bgould/kint/parts.txt

https://www.digikey.com/en/products/detail/jst-sales-america-inc/BM04B-SRSS-TB-LF-SN/926696
https://www.digikey.com/en/products/detail/jst-sales-america-inc/SM04B-SRSS-TB-LF-SN/926710
