bgould/kint/schematic-v2023-03-18.pdf

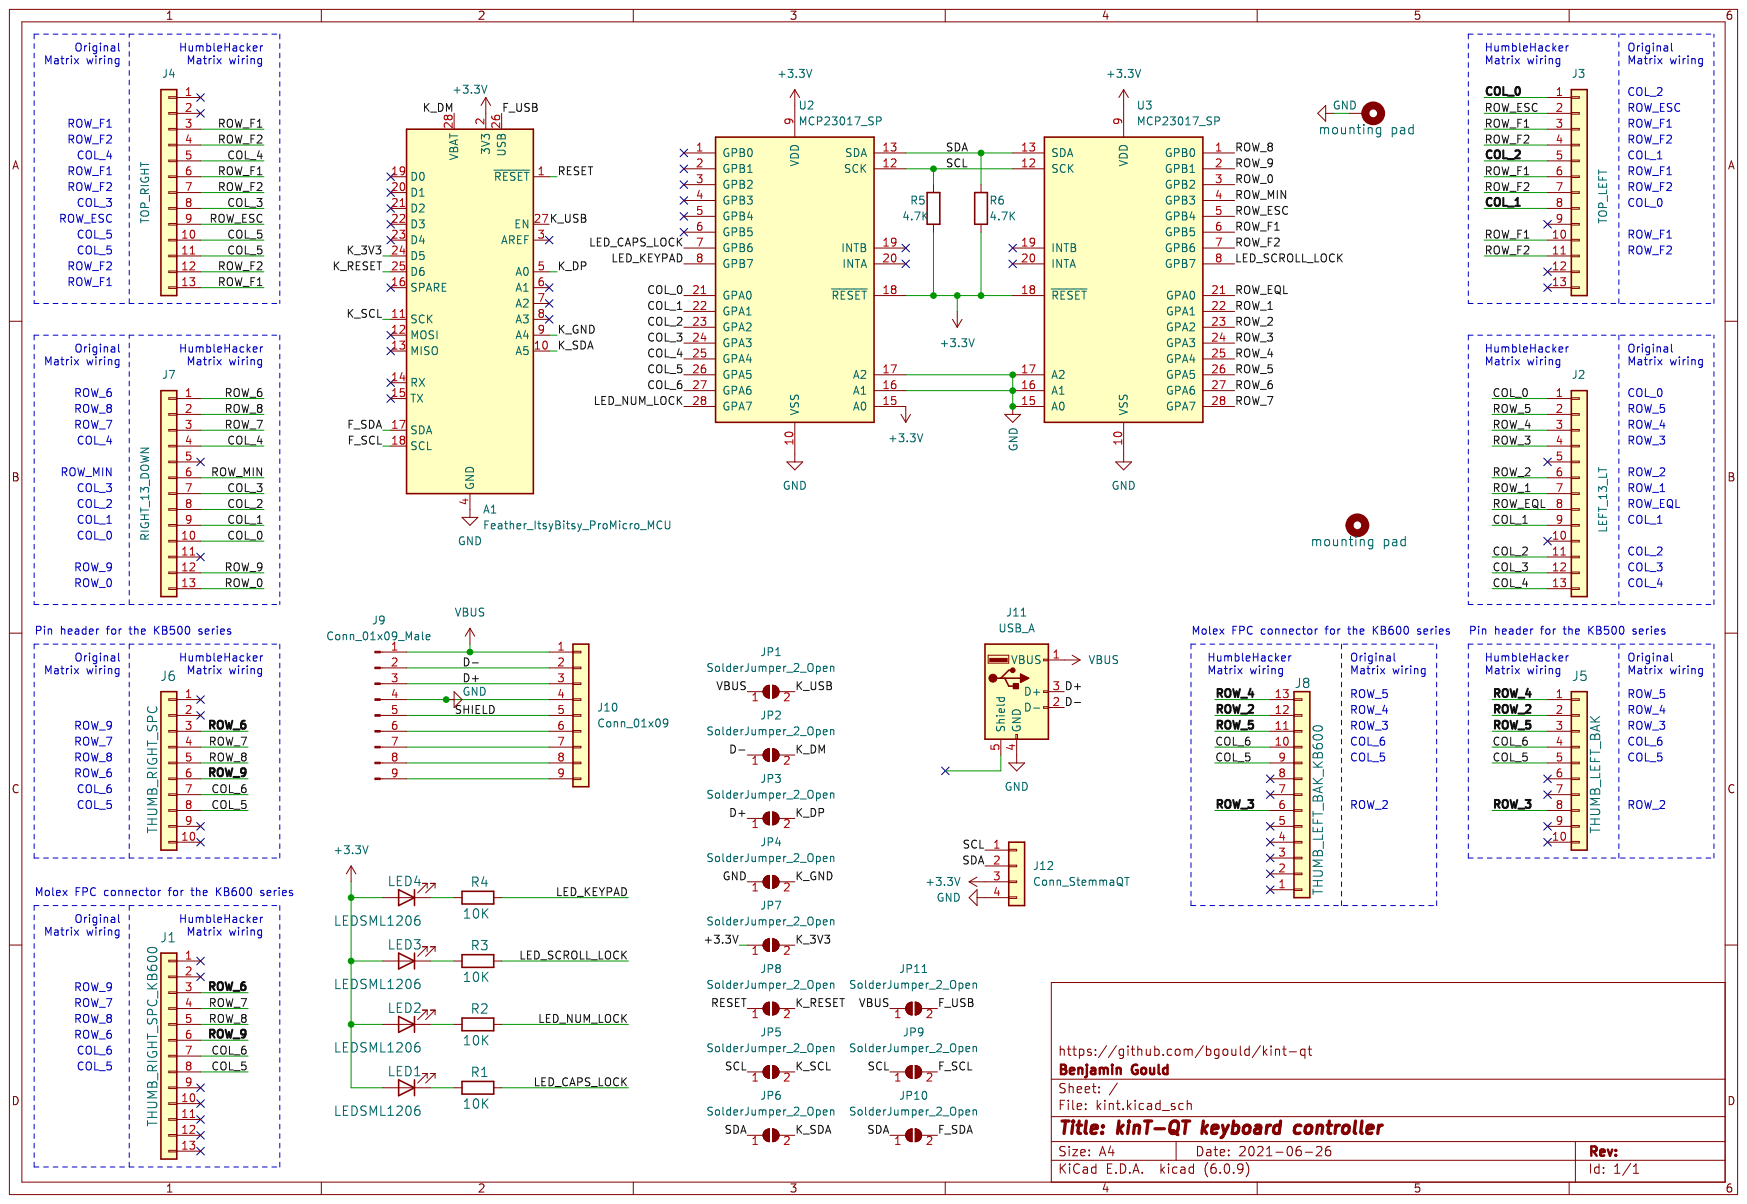
[picture p8: page 1]
