bgould/kint/kicad/kint - without feather.kicad_pcb

## KiCad design kicad/kint - without feather.kicad_pcb (2023-01-08)

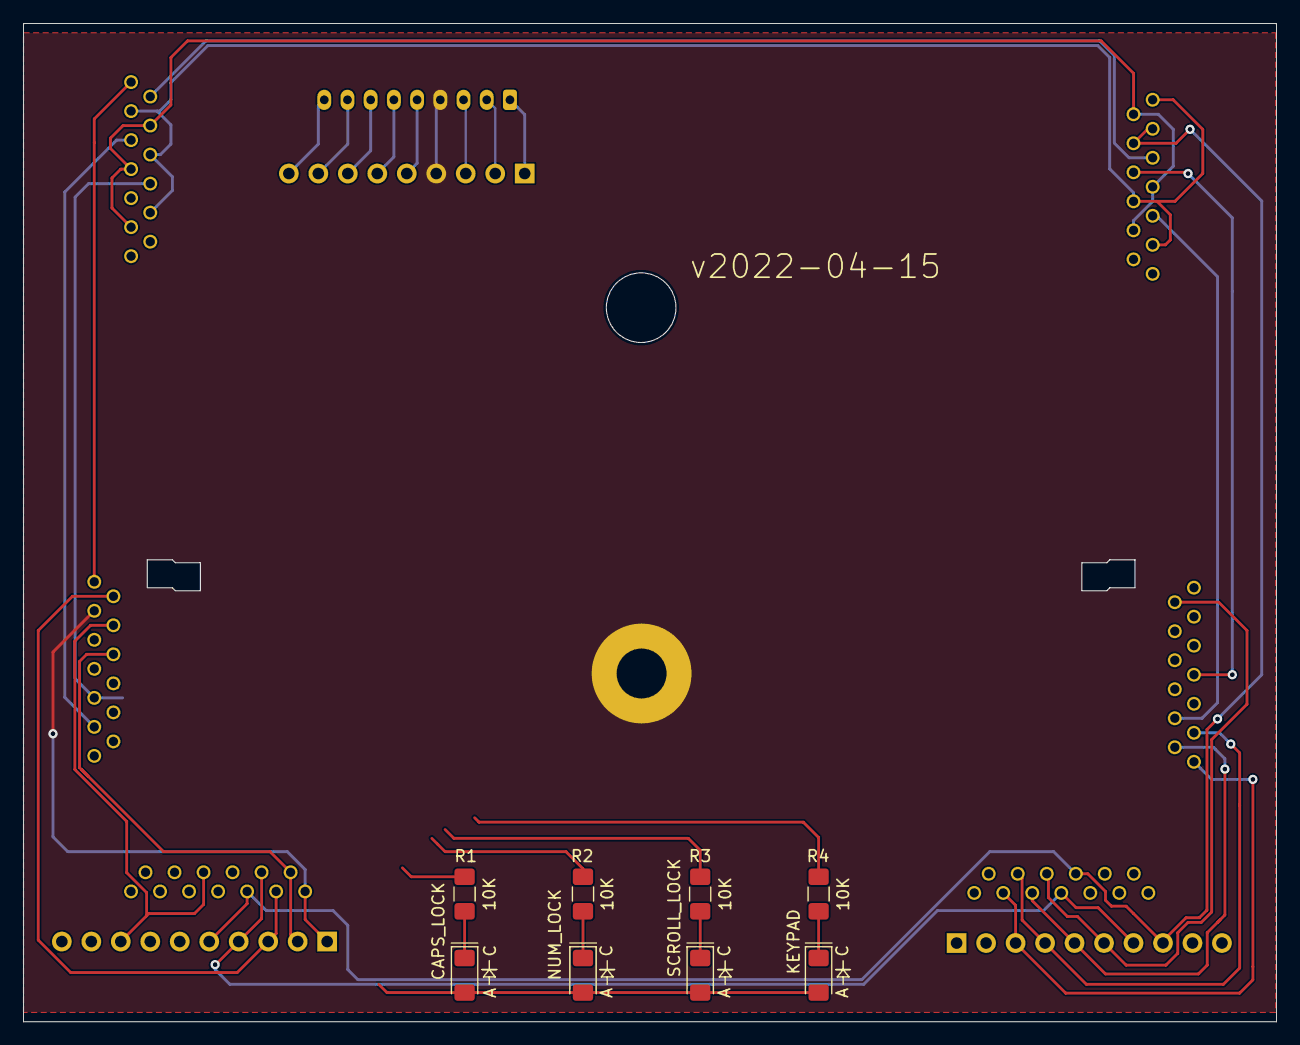
[picture p12: board kint - without feather.kicad_pcb from above]

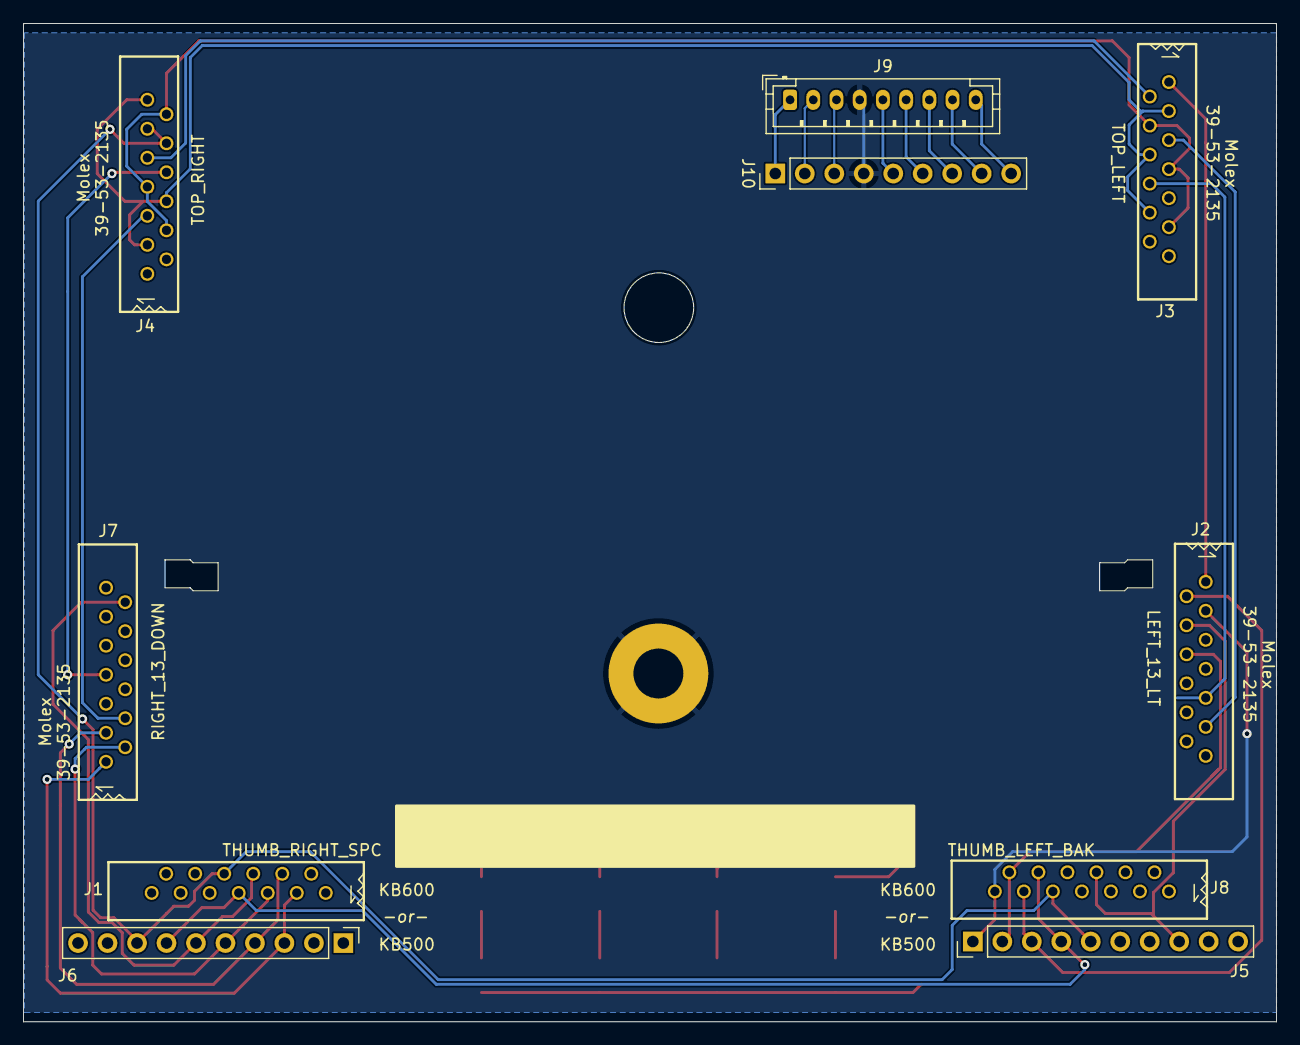
[picture p13: board kint - without feather.kicad_pcb from below]

Board: 2 copper layers, 107.9 x 86.0 mm, 20 parts (10 on the bottom side), 32 nets.

Parts:
H1: mounting pad; MountingHole_4.3mm_M4_Pad
H2: mounting pad; MountingHole_6mm
J1: THUMB_RIGHT_SPC_KB600; 39-53-2135
J2: LEFT_13_LT; 39-53-2135
J3: TOP_LEFT; 39-53-2135
J4: TOP_RIGHT; 39-53-2135
J5: THUMB_LEFT_BAK; PinHeader_1x10_P2.54mm_Vertical
J6: THUMB_RIGHT_SPC; PinHeader_1x10_P2.54mm_Vertical
J7: RIGHT_13_DOWN; 39-53-2135
J8: THUMB_LEFT_BAK_KB600; 39-53-2135
J9: Conn_01x09_Male; JST_PH_B9B-PH-K_1x09_P2.00mm_Vertical
J10: Conn_01x09; PinHeader_1x09_P2.54mm_Vertical
LED1, LED2, LED3, LED4: LEDSML1206; LED_1206_3216Metric_Pad1.42x1.75mm_HandSolder
R1, R2, R3, R4: 10K; R_1206_3216Metric_Pad1.42x1.75mm_HandSolder

Connections:
+3.3V: LED1.2 (A), LED2.2 (A), LED3.2 (A), LED4.2 (A)
/COL_0: J2.1, J3.1, J7.10
/COL_1: J2.9, J3.8, J7.9
/COL_2: J2.11, J3.5, J7.8
/COL_3: J2.12, J4.8, J7.7
/COL_4: J2.13, J4.5, J7.4
/COL_5: J1.8, J4.10, J4.11, J5.5, J6.8, J8.9
/COL_6: J1.7, J5.4, J6.7, J8.10
/D+: J9.2, J10.2
/D-: J9.3, J10.3
/ROW_2: J2.6, J5.2, J8.12
/ROW_3: J2.4, J5.8, J8.6
/ROW_4: J2.3, J5.1, J8.13
/ROW_5: J2.2, J5.3, J8.11
/ROW_6: J1.3, J6.3, J7.1
/ROW_7: J1.4, J6.4, J7.3
/ROW_8: J1.5, J6.5, J7.2
/ROW_9: J1.6, J6.6, J7.12
/ROW_ESC: J3.2, J4.9
/ROW_F1: J3.3, J3.6, J3.10, J4.3, J4.6, J4.13
/ROW_F2: J3.4, J3.7, J3.11, J4.4, J4.7, J4.12
GND: H1.1, J9.4, J10.4
unnamed: J9.5, J10.5
unnamed: J9.6, J10.6
unnamed: J9.7, J10.7
unnamed: J9.8, J10.8
unnamed: J9.9, J10.9
unnamed: LED1.1 (K), R1.2
unnamed: LED2.1 (K), R2.2
unnamed: LED3.1 (K), R3.2
unnamed: LED4.1 (K), R4.2
VCC: J9.1, J10.1
