bgould/kint/(commit log)

2023-03-18 fixing routing for D+ and D-
    [kint.kicad_pcb, kint.kicad_sch]
2023-03-18 Updating schematic title and images
    [kint.kicad_sch]
2023-03-18 fixed link to schematic
2023-03-18 fixing schematic
2023-03-22 Updating BOM list
