bgould/kint/(notices)

Notices in the files:
kicad/kint.kicad_pcb:
(c) 2023, Benjamin Gould
Open Hardware: CC-BY-SA
